ShigeichiroYamasaki/mosquito-trap-esp32s3/docs/hardware.md

# ハードウェア

[ボード写真・公式ピン配置図・Arduino IDEの設定](./getting-started.md)を確認してから配線してください。

## 採用する構成

| 部分 | 設計方針 |
| --- | --- |
| 制御ボード | Freenove ESP32-S3 Board Lite（カメラなし） |
| Flash Size 設定 | 16MB（使用者確認済み） |
| PSRAM 設定 | OPI PSRAM、容量 8MB（使用者確認済み） |
| 開発 | macOS / Arduino IDE / USB 接続 |
| CO₂ 誘引源 | 重曹とクエン酸で CO₂ を発生 |
| 人工皮膚 | 人間が半日以上履いた靴下を5V電源のヒーターで36°Cに加温 |
| ケース | 10cm角。ヒーター付き人工皮膚を格納、匂いは自然拡散 |
| 拡散ファン | 人工皮膚と分離したCO₂専用流路に配置、5V。噴出口はケース近傍で靴下に直風を当てない |
| 拡散リズム | 555 タイマー IC で 4〜6秒間隔の間欠動作を実装 |
| 発光部 | 赤外線 LED 2個を時間差で交互に点灯し、視差を表現 |
| 受光部 | Moechando 940nm・5mm 赤外線レシーバー、横6個 × 3列（計18個）を現在配置 |
| 検出 | 蚊の影とその動きを認識 |
| 捕獲 | DCモーターのコンパクト掃除機。内部回路は改造せず、サーボでプッシュボタンを操作。停止から1回で弱、2回で強、3回で停止。検出時にサーボで2回押し、吸引後に1回押して停止 |

詳細は [誘引・検出・吸引の機構](./mechanism.md) を参照してください。上記は設計方針であり、実機での動作確認を示すものではありません。

現在の掃除機は小型さとUSB配線の簡単さを重視して選定しています。将来はAC電源のハンディ掃除機への変更を検討します。[写真・採用理由・スイッチ操作](./mechanism.md#掃除機の選定)を参照してください。

## 検出・吸引制御部の部品構成

| 部品 | 数量 | 仕様・用途 |
| --- | --- | --- |
| Freenove ESP32-S3 Board Lite | 1台 | カメラなし、Flash 16MB、PSRAM 8MB（OPI） |
| フォトトランジスタ | 18個 | Moechando 940nm・5mm、横6個×3列 |
| 赤外線 LED | 2個 | 時間差で交互点灯 |
| サーボモータ | 1個 | 掃除機のボタンを操作 |
| アナログマルチプレクサ CD74HC4067 | 2個 | 18個の受光信号を切り替えてADCに入力 |

この一覧は検出・吸引制御部の構成です。CO₂ 発生部、人工皮膚、ヒーター、555タイマー、拡散ファン、掃除機もシステムに含みます。

### CD74HC4067 とテストコードの対応

CD74HC4067 は16:1のアナログマルチプレクサで、2個で計32入力分の切替経路を用意できます。現在のテストコードはそのうち18入力を使用します。複数のアナログ信号を順番にADCへ接続する方式で、同時に18点を変換するものではありません。[TI 公式仕様](https://www.ti.com/product/CD74HC4067)

| コード上の接続 | 使用入力 | ESP32-S3 |
| --- | --- | --- |
| MUX1 | CH0〜CH15：PT1〜PT16 | 共通信号端子を GPIO1（ADC）へ |
| MUX2 | CH0〜CH1：PT17〜PT18 | 共通信号端子を GPIO2（ADC）へ |
| 共通選択線 | S0 / S1 / S2 / S3 | GPIO6 / 7 / 8 / 9 |

2個のMUXは選択線を共有し、信号端子は別々のADC入力へ接続するコード構成です。MUX2のCH2〜CH15は読み取り対象外です。使用者から提示された電源・EN・信号線の配線を以下に記録します。PT番号から横6個×3列の物理的位置への対応と、実機での全入力の動作は未確認です。

### MUXの配線（使用者指定）

| CD74HC4067端子 | MUX1 | MUX2 |
| --- | --- | --- |
| VCC | 3.3V | 3.3V |
| GND | ESP32と共通のGND | ESP32と共通のGND |
| EN | GND | GND |
| SIG | GPIO1 | GPIO2 |
| S0 | GPIO6 | GPIO6 |
| S1 | GPIO7 | GPIO7 |
| S2 | GPIO8 | GPIO8 |
| S3 | GPIO9 | GPIO9 |

ENをGNDに固定し、両MUXを有効にする構成です。SIGはGPIO1とGPIO2に分け、選択線S0〜S3を共有します。端子の呼称C0〜C15とCH0〜CH15は、この文書では同じチャンネル番号を表します。

### フォトトランジスタ18個の配線（使用者指定）

各フォトトランジスタに100kΩのコレクタ側抵抗を1本ずつ接続します（計18本）。抵抗下端・コレクタ・MUX入力を同じ接点に接続し、エミッタは共通GNDに接続します。

```text
     3.3V
       │
     100kΩ    ← 各受光素子に1本
       │
       ├──── MUX Cn
       │
   Collector
 フォトトランジスタ
    Emitter
       │
      GND
```

- MUX1 C0〜C15：PT1〜PT16
- MUX2 C0〜C1：PT17〜PT18

これは18点配列に使用する指定配線です。100kΩの単体感度試験結果と、MUX経由の18点読み取り・応答時間の検証は区別します。

### LEDとサーボの信号線（使用者指定）

| ESP32-S3 Board Lite | 接続先 |
| --- | --- |
| GPIO10 | 左赤外線LED制御 |
| GPIO11 | 右赤外線LED制御 |
| GPIO16 | サーボ信号 |

以上のGPIOとMUXチャンネル割り当ては、提供されたハードウェアテストコードの定数・読み取り処理と一致しています。LED駆動回路は下記の使用者指定です。サーボの電源・信号配線も下記の使用者指定です。

### 赤外線LEDの駆動回路（使用者指定）

左右それぞれに以下の回路を1組ずつ用意します。必要数は赤外線LED・2N2222・330Ω抵抗・1kΩ抵抗が各2個です。

```text
+5V ── 330Ω ── IR LED アノード
IR LED カソード ── 2N2222 Collector
2N2222 Emitter ── 共通GND
ESP32 GPIO ── 1kΩ ── 2N2222 Base

左：GPIO10    右：GPIO11
```

2N2222を使うローサイド駆動の指定です。5V電源のGNDとESP32・受光回路のGNDを共通にします。GPIOをHIGHにして点灯するテストコードと対応します。実機での点灯と電流は未検証です。

使用者から提示された端子図は次のとおりです。

```text
 2N2222
   ___
 /_____\
  | | |
  E B C
```

この端子図のメーカー・製品型番・パッケージ・見る方向は未確認です。E/B/Cの実端子番号は、使用部品のデータシートと照合して確定します。上の図を2N2222全製品に共通する端子順として扱いません。

LEDの順方向電圧・定格電流と2N2222の電圧降下が未確認のため、330Ωでの実電流はまだ確定していません。単体受光テストの常時点灯回路に使った220Ωと、今回指定された駆動回路の330Ωは別の試験条件として記録します。

### サーボの配線（使用者指定）

| サーボ線 | 接続先 |
| --- | --- |
| 赤 | +5V |
| 黒／茶 | 共通GND |
| 信号 | ESP32-S3 GPIO16 |

サーボ電源のGNDはESP32・MUX・受光回路・LED駆動回路と共通にします。5Vの給電元・必要電流容量とサーボ型番は未確定です。この配線指定は、MacのUSB電源だけで全負荷を駆動できることを確認したものではありません。

テストコードの `SERVO_PIN = 16` と一致します。起動時には待機角20°へ動き、押下角は65°に設定されています。これらの角度でボタンを押せるか、取り付けた実機での確認は別途必要です。

## 単体受光テストの結果

使用者報告では、フォトトランジスタのコレクタ側抵抗は **10kΩで感度不足、100kΩで十分な感度**でした。抵抗増加による応答の遅れも確認項目です。応答時間の数値と18点配列での適合性は未確認です。[実験記録](./roadmap.md)に回路・測定条件と評価範囲を記載しています。

## 使用ボード

使用するボードは **Freenove ESP32-S3 Board Lite（カメラなし）**です。使用者から Board Lite（カメラなし）と指定されています。モジュール刻印は未確認です。Flash Size は使用者の確認により **16MB** として確定しました。

Arduino IDE の設定は **Flash Size: 16MB / PSRAM: OPI PSRAM（8MB）** です。これらは使用者が確認した設定値であり、この構成での統合動作は未検証です。USB 設定は引き続き確認する項目です。

## 実装前に決めること

| 項目 | 状態 |
| --- | --- |
| ボードの詳細品番・モジュール刻印、USB 端子 | 実物・製品資料で確認予定 |
| CO₂ 発生部の構造・放出条件 | 未確定 |
| ケースの高さ・内外寸、開口部、ファンの送風方向 | 未確定 |
| 5Vファンの型番・電流 | 未確定。NE555・IRLZ44Nの回路定数は[4秒タイマー](#fan-timer)を参照 |
| ファンの ON/OFF 時間の内訳・周期調整方式 | 未確定 |
| ヒーター・温度センサー・駆動回路 | 未確定 |
| 2個の発光 LED の型番・波長・間隔・向き・点灯タイミング、2N2222の実端子順、受光素子の詳細型番・電気特性・間隔・読み取り回路 | 未確定 |
| 掃除機・サーボの型番と機械的な取付方法 | 未確定 |
| 5V電源の給電元・電流容量 | 未確定（MUX・受光部・LED・サーボの配線は上記の指定あり） |

最初はボード単体の USB 通信を確認します。ヒーターやサーボの電源は部品仕様に合わせて設計し、GPIO から負荷を直接駆動しません。

テスト版のGPIO割り当ては上記の使用者指定と一致しています。初期スケッチは GPIO を操作しません。[テスト版](./hardware-test.md)は記載の GPIO を操作し、起動時にもサーボを動かします。

## CO₂ファン用4秒タイマー {#fan-timer}

NE555を5Vで動作させ、IRLZ44NでCO₂専用5Vファンを間欠駆動します。**約1.98秒運転＋約2.00秒停止＝約3.98秒周期**の設計です。部品誤差や起動時の過渡動作を含む実測値は未確認です。ヒーター電源も5Vですが、ヒーターはこのタイマーで断続運転せず、温度制御を別に設計します。

| 部品 | 値・用途 |
| --- | --- |
| RA | 1kΩ |
| RB | 130kΩ（120kΩ＋10kΩの直列でも可） |
| C | 22µF、定格10V以上の電解コンデンサー |
| CONT用 | 10nF、NE555の5番とGND間 |
| 電源バイパス | 100nF、NE555の8番と1番の直近 |
| 反転・ゲート駆動 | 2N2222 × 1、ベース抵抗10kΩ |
| ゲート用 | プルアップ4.7kΩ、直列100Ω、プルダウン100kΩ |
| ファンスイッチ | IRLZ44N |
| ファン保護ダイオード | ファンの電流・電圧に合わせて選定 |

### NE555の発振回路

```text
+5V ── RA 1kΩ ──┬── RB 130kΩ ──┬── C 22µF ── GND
                 │               │   ＋    −
               7番             2番・6番

8番 VCC   → +5V
4番 RESET → +5V
1番 GND   → GND
5番 CONT  → 10nF → GND
3番 OUT   → 下記のゲート駆動回路
```

定常動作時の計算式は次のとおりです。[TI NE555データシート](https://www.ti.com/lit/ds/symlink/ne555.pdf)

```text
tHIGH = 0.693 × (RA + RB) × C ≒ 2.00秒
tLOW  = 0.693 × RB × C        ≒ 1.98秒
周期  = tHIGH + tLOW          ≒ 3.98秒
```

22µFの容量誤差により周期は変わります。調整する場合はRBを100kΩ＋100kΩ半固定抵抗に置き換え、実測で4秒に合わせます。半固定抵抗は摺動端子と一方の端子を接続して使用します。

### IRLZ44Nによるファン駆動

NE555の5V動作時のHIGH出力は電源電圧まで上がるとは限りません。IRLZ44Nのゲートに5Vに近い電圧を与えるため、2N2222とプルアップ抵抗を追加します。[IRLZ44Nデータシート](https://www.infineon.com/assets/row/public/documents/24/49/infineon-irlz44n-datasheet-en.pdf)

```text
NE555 3番 ── 10kΩ ── 2N2222 Base
                       Emitter ── GND

+5V ── 4.7kΩ ──┬── 100Ω ── IRLZ44N Gate
                │
          2N2222 Collector

IRLZ44N Gate ── 100kΩ ── GND
IRLZ44N Source ── GND

+5V ── ファン ＋
       ファン − ── IRLZ44N Drain

保護ダイオード：カソード → +5V、アノード → Drain
```

信号が反転するため、NE555のLOW中にファンが運転し、HIGH中に停止します。GNDは共通にします。2N2222の端子配列は製品のデータシートで確認します。電源容量と保護ダイオードの定格は、ファンの起動電流に合わせて選びます。

ファンの立ち上がりとチューブ内の滞留により、CO₂濃度の波形は電気的なON/OFF波形と異なります。接近位置の濃度変化を測定して評価します。
