ShigeichiroYamasaki/mosquito-trap-esp32s3/(commit log)

2026-09-10 Initialize ESP32-S3 Arduino project and VitePress docs
2026-09-10 Specify 10cm enclosure and 555-timed 5V dispersion fan
2026-09-10 Record Freenove ESP32-S3 16MB board
2026-09-10 Record Arduino Flash Size setting as 4MB
2026-09-10 Confirm 8MB OPI PSRAM capacity
2026-09-10 Document alternating infrared LEDs for shadow comparison
2026-09-10 Specify vacuum button cycle and two-plus-one servo sequence
2026-09-10 Record phototransistor collector resistor test results
2026-09-10 Specify Board Lite and dual CD74HC4067 component inventory
2026-09-10 Document complete MUX, receiver, LED driver and servo wiring
2026-09-10 Add overview and functional circuit diagrams with code links to homepage
2026-09-10 Implement calibrated optical tracking and document compound-eye design
2026-09-10 Clarify capture before shadow disappearance with three-frame diagram
2026-09-10 Document ESP32 setup, local contrast, and vacuum selection
2026-09-10 Document NE555 four-second fan timer and 5V heater supply
